vophucthinh2006/DrowsyGuard-EdgeAI-HackTheChallenge2026/specs/09-ui-dashboard-spec.md

# 09 — UI Dashboard Specification (UI-SPEC-09)

**Document:** DG-SPEC-09 · Rev 0.1 · 2026-08-11 · DRAFT
**Applies to:** DrowsyGuard Desktop Demo (UI + Bridge)

---

## 1. Purpose and scope

### 1.1 Purpose

This document specifies the requirements, architecture, data interfaces and UI behaviour for the
desktop demonstration application that implements a vehicle-style instrument cluster ("car
display") for the DrowsyGuard system. The application is intended for demo and developer use and
must be capable of running with live CAN data, replayed traces, or fully simulated inputs.

### 1.2 Scope — in

- Desktop UI application that renders speedometer, secondary gauge (RPM/HP), odometer, ambient
  temperature, and vehicle indicator icons.
- Realtime reception and rendering of CAN-derived vehicle signals.
- Hard-realtime rendering of alert events produced by the UNO Q node and visualisation of the
  corresponding hardware actions (buzzer, vibration, fan, etc.).
- Developer modes: `live`, `replay`, `simulate` with configurable mapping from the canonical
  ICD (`shared/icd/icd.yaml`).

### 1.3 Scope — out

- This tool is a demonstration/UI product only and does not implement vehicle control logic.
- It shall not be used as a safety controller; the VCS MCU remains the single-source-of-truth for
  safety-critical actuation.

---

## 2. System context

The UI sits alongside a small native bridge service which performs CAN and serial I/O. The
bridge exposes a local WebSocket API consumed by the Electron UI. The diagram below shows the
logical data flows.

```
            +--------------------------+     WebSocket (MessagePack)     +-------------+
            |   bridge (Rust binary)   | <-------------------------------- |  UI (React)  |
            |  - reads CAN adapters     |                                   |  - renders   |
            |  - reads UNO Q serial    | -----> messages: can_signal,      |    dials &   |
            |  - replay / simulate     |        uno_alert, heartbeat,     |    alerts    |
            +-----------+--------------+                                   +------+------+
                        |  CAN frames (live or replay)                            |
                        |                                                      +-v--+
                +-------v------+                                               |Dev| 
                | CAN Adapter  |                                               |Panel|
                +--------------+                                               +----+
```

Also see the sequence overview (mermaid):

```mermaid
sequenceDiagram
  participant Bridge
  participant UI
  Bridge->>UI: can_signal (MessagePack)
  Bridge->>UI: uno_alert (MessagePack)
  UI->>UI: render/update dials
  UI->>User: show alert overlay + sound
```

---

## 3. Requirements

### 3.1 Functional

- UI-FN-001 — The UI SHALL accept messages of type `can_signal` and `uno_alert` over a local
  WebSocket and update visuals accordingly.
- UI-FN-002 — The UI SHALL provide modes `live`, `replay`, and `simulate` selectable from the
  developer panel.
- UI-FN-003 — The UI SHALL display UNO Q alerts immediately on receipt and visualise `actions`.

### 3.2 Non-functional

- UI-NF-001 — UNO Q alert end-to-end render latency SHALL target ≤ 50 ms typical, worst-case ≤ 100 ms.
- UI-NF-002 — The UI SHALL render smooth dial animation at a configurable rate (default 20 Hz).
- UI-NF-003 — WebSocket binding SHALL default to `localhost` for security.

---

## 4. Message definitions

- `can_signal` — periodic message containing decoded signal values.

```json
{
  "type": "can_signal",
  "ts": 1680000000.123,
  "signals": { "vehicle.speed_kmh": 99.0, "vehicle.rpm": 2500 }
}
```

- `uno_alert` — high-priority event originating from UNO Q.

```json
{
  "type": "uno_alert",
  "ts": 1680000001.456,
  "code": "DROWSY_L2",
  "level": 2,
  "message": "Driver drowsy - high",
  "actions": ["buzzer","vibrate","fan"]
}
```

Notes: MessagePack MUST be used at runtime for compactness and low parsing overhead; the JSON
snippets above are for documentation only.

---

## 5. Signal → Widget mapping (minimum)

- `vehicle.speed_kmh` → Speedometer (left dial, numeric + arc)
- `vehicle.rpm` → RPM / secondary gauge (right dial)
- `vehicle.odo_km` → Odometer (text)
- `vehicle.temp_c` → Temperature indicator
- boolean indicators → Top icon strip (turns, lights, seatbelt)

Mapping rules SHALL be supplied in `config/signal_map.yaml` derived from `shared/icd/icd.yaml`.

---

## 6. Alert behaviour and prioritisation

- Alerts include `level` ∈ {0,1,2,3}. UI SHALL present visual & audio behaviour by level:
  - Level 1: Amber banner (soft beep)
  - Level 2: Red overlay (loud alarm + flash)
  - Level 3: Full-screen modal (repeating alarm) — requires clear from UNO Q or timeout

- If multiple alerts present, UI SHALL surface the highest level; others are retained in the
  alert log accessible from the developer panel.

---

## 7. Performance considerations

- Use a Web Worker to decode MessagePack and forward parsed objects to the UI renderer via
  `postMessage` to avoid blocking the main thread.
- UNO alert messages MUST be processed and enqueued on a high-priority path; they must not be
  dropped due to CAN frame backpressure.
- Bridge SHALL implement bounded CAN queues and drop oldest frames when saturated.

---

## 8. UI layout & visual guidance

- Provide two resolution-aware themes (`theme/light`, `theme/dark`) and scale all canvases by
  `devicePixelRatio` for crisp rendering.
- Use vector assets (SVG) for icons. Speed numeric font size target 48–72px.
- Include accessibility options: high-contrast, large-text, disable-flash.

---

## 9. Developer deliverables

- `config/signal_map.yaml` (mapping file)
- `examples/replay/sample_replay.msgpack` and `examples/alerts/sample_alerts.msgpack`
- Build and run instructions in `README.md` at the project root.

---

## 10. Traceability

This document traces to the top-level system requirements in [01](01-system-requirements.md) and
to the CAN ICD in [04](04-interface-control-document.md).

---

End of UI specification.
