vophucthinh2006/DrowsyGuard-EdgeAI-HackTheChallenge2026/Images/drowsyguard-poster.JPG

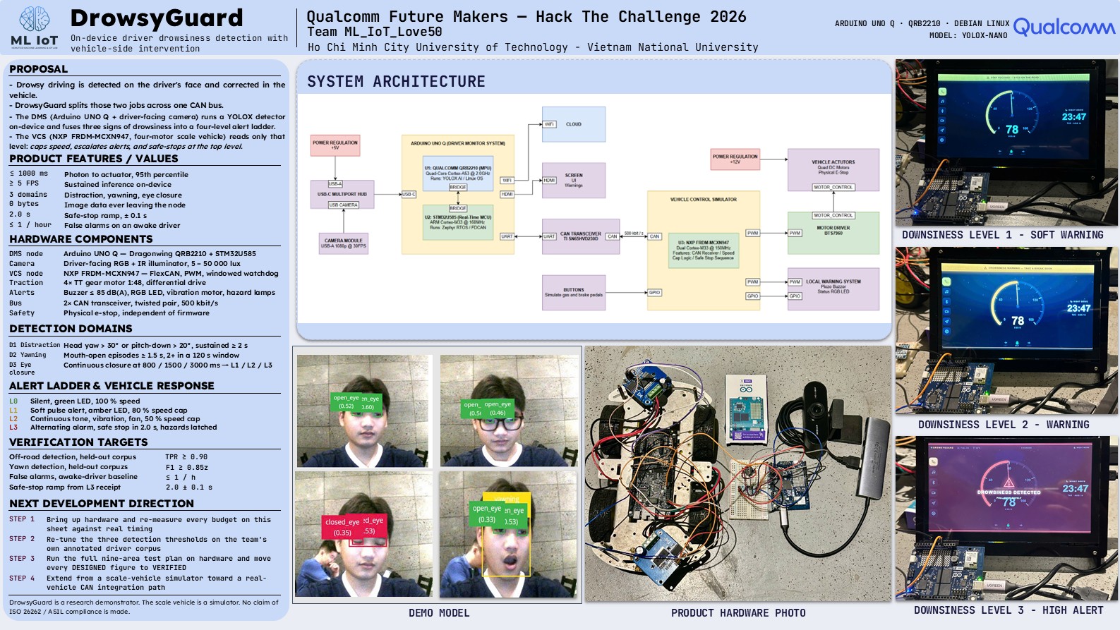
Images/drowsyguard-poster.JPG
