vophucthinh2006/DrowsyGuard-EdgeAI-HackTheChallenge2026/vcs-mcxn947/WORKLOG_2026-08-15.md

# Work log — 2026-08-15 — vcs-mcxn947 (FRDM-MCXN947 VCS node)

Session covered two phases: (1) simplifying the firmware to match the
system block diagram exactly, and (2) a full hardware bring-up debugging
session for the BTS7960 motor stage, which turned into tracking down a
silent PWM1 fault-mapping bug. Root-cause detail for phase 2's bug is in
[`PWM_FAULT_BUG_POSTMORTEM.md`](./PWM_FAULT_BUG_POSTMORTEM.md); this file is
the chronological log of everything touched.

## Phase 1 — system diagram compliance

Goal: make `vcs-mcxn947` match ONLY what's in the shared system block
diagram — no more, no less.

**Removed** (not in the diagram's "Local Warning System" / control scope):
- Vibration motor output.
- Fan relay output.
- Hazard lamps (left/right).
- ACK button input.
- REARM button input.
- Physical ESTOP_SENSE input.

**Added:**
- Gas pedal simulation via the board's own onboard **SW2** button
  (Wakeup, `P0_23`/`WAKEUP_B`) — no external wiring needed.
- Brake pedal simulation via the board's own onboard **SW3** button
  (ISP mode switch, `P0_6`/`ISPMODE_N-DEBUG`, per UM12018 Table 4 — usable
  as a general-purpose input once past boot; must not be held during
  power-on/reset since the boot ROM samples it for ISP mode selection).
- Automatic re-arm logic (`SafeConditionsSustained()` in `safety.c`,
  1000 ms of continuous safe conditions required) replacing the removed
  manual REARM button.

**Files touched:**
- `board_port/cm33_core0/app.h` — removed VIBRATION/FAN_RELAY/HAZARD_L/
  HAZARD_R/ACK_BUTTON/REARM_BUTTON/ESTOP_SENSE macros; added
  `GAS_BUTTON_GPIO`/`PIN`, `BRAKE_BUTTON_GPIO`/`PIN`.
- `board_port/cm33_core0/pin_mux.c` — matching pin init changes; removed
  now-unused `kCLOCK_Port4`/`kCLOCK_Gpio4`/`kCLOCK_Gpio2` clock enables
  (kept `kCLOCK_Port2`, still needed for PWM pin muxing).
- `src/alerts/alerts.c` / `alerts.h` — removed vibration/fan/hazard GPIO
  writes from every `Alerts_Tick()` condition branch.
- `src/safety/safety.c` / `safety.h` — `dg_safety_inputs_t` reduced to
  `throttle_nonzero`, `motor_current_ma`, `motor_rail_mv` (removed
  `operator_rearm_pressed`, `ack_pressed`, `estop_sense_asserted`).
  DISARMED→ARMED_IDLE transition is now unconditional (no calib-done gate,
  no button press needed).
- `src/main.c` — removed ACK/REARM/ESTOP_SENSE debounced-input handling;
  added `s_gasButton`/`s_brakeButton` debounced inputs with edge-detection
  logging.
- `PINOUT.md` — new file, single source of truth for the pinout (CAN, motor
  driver, buzzer+LED, gas/brake, debug console), with a "Removed
  2026-08-15" section documenting what was taken out and why.

**CAN-063 fail-safe adjustment:** "absence of a valid CAN frame is never
treated as driver-is-fine" needed refinement to distinguish two cases:
- Never had a DMS-AP peer at all (standalone bench test) → treated as safe
  (L0). Tracked via a new `haveDms` flag.
- Had a DMS-AP peer and then lost it → still treated as danger (L3), per
  the original CAN-063 intent.

`src/safety/safety.c`: `fault_can_timeout` is now
`everHadDms && (link == kDgLinkLost)` (was unconditional); alert-level
fallback is `haveDms ? kDgAlertL3Danger : kDgAlertL0Normal` when driver
state isn't known.

`src/can_link/can_link.c`: added link-state-change logging
(`LogLinkStateChange()`, `[can] link OK -> DEGRADED` etc.) and
alert-level-change logging (`[can] DMS alert_level -> L2_DROWSY`), both
gated on actual state transitions (not spammed every tick).

## Phase 2 — BTS7960 motor bring-up + PWM1 debugging

Started from: `state=RUN`, correct duty cycles computed in software, but
**zero volts** on motor M+/M- terminals and a real physical buzzer making no
sound.

### Simplified test mode added first

Per request, added a "tap SW2 = motor runs, tap SW3 = stop" latching test
mode in `main.c`'s `ControlTask` (`s_motorLatchedOn`, toggled on gas/brake
button edges) to validate the BTS7960 hardware directly, bypassing the full
vehicle-control ramp logic. (Fixed an edge-detection ordering bug introduced
while wiring this up: `prevGas`/`prevBrake` were being updated *before* the
edge check instead of after, making the latch toggle never fire — moved the
`prevGas = gas; prevBrake = brake;` assignment to run after both edge
checks.)

### 2-phase raw-GPIO-then-PWM isolation test

Added `Alerts_RunPinBringupTest()` in `alerts.c`: phase 1 reconfigures the
buzzer pin (PORT2 pin 2, J3-7) as plain GPIO and toggles it 1 Hz for 10 s
(no PWM1 involved at all); phase 2 restores the PWM1_A2 pin config and
turns the buzzer on continuously. Result: **phase 1 audible, phase 2
silent** — isolated the bug specifically to PWM1, ruling out pin/wiring/
board-level causes.

### Reference example cross-check

Built and flashed the MCUXpresso SDK's own **unmodified**
`driver_examples/pwm/pwm_3ph` example directly (bypassing this project's
codebase). Confirmed audible PWM output on the same physical buzzer —
proved hardware/board/SDK were all fine, and the bug had to be in this
project's own source.

### Root cause found and fixed

Added a live PWM1 register dump to the phase-2 test. Found
`PWM1->SM[2].DISMAP[0] == 0xFFFF` (silicon reset default — not something
this project's code had set) mapping all 4 fault inputs to disable every
PWM1 output on every submodule, combined with those fault inputs floating
high (unconnected — this design has no fault sensors) and the default
combinational fault path being live. `FCTRL`/`FSTS`/`DISMAP` are PWM1-
module-wide, explaining why buzzer *and* all motor channels were silent at
once. Full analysis in
[`PWM_FAULT_BUG_POSTMORTEM.md`](./PWM_FAULT_BUG_POSTMORTEM.md).

**Fix:** `board_port/cm33_core0/hardware_init.c` now explicitly clears
`PWM1->SM[0..3].DISMAP[0] = 0U` right after the PWM1 sub-clock enables.

**Verification so far:** rebuilt (`-Werror`, 0 warnings), reflashed,
captured two independent serial register dumps confirming `OUTEN`/`MCTRL`/
duty registers (`VAL3 = 25000`, 50% of a 50000-tick period) and `DISMAP`'s
functional bits all read back correct. **Audible confirmation on real
hardware is still pending** as of this writeup.

### Other real (if minor) bugs found and fixed along the way

- `SYSCON->PWM1SUBCTL` was only enabling sub-clocks for 3 submodules
  (`CLK0_EN|CLK1_EN|CLK2_EN`) while this project actually uses 4
  (SM0/1/2/3 — SM3 borrowed for the right motor's LPWM since SM1's own B
  channel isn't header-accessible). Added `CLK3_EN`. Real bug, but
  insufficient alone to explain full silence — see postmortem.
- Missing WWDT0 functional clock, found earlier by flashing to hardware:
  without it, `WWDT_Init()`'s internal wait-for-clock spin hung boot
  silently. Fixed with `CLOCK_SetClkDiv(kCLOCK_DivWdt0Clk, 1U)` +
  `SYSCON_CLOCK_CTRL_FRO1MHZ_CLK_ENA_MASK` in `hardware_init.c`.

## Files with uncommitted changes as of this writeup

```
 M board_port/cm33_core0/hardware_init.c
 M src/alerts/alerts.c
 M src/alerts/alerts.h
 M src/can_link/can_link.c
 M src/main.c
 M src/motion/motion.c
 M src/safety/safety.c
```

## Pending / next steps

1. **Get audible confirmation from the user** that the buzzer (and then the
   motors) actually work now that `DISMAP` is cleared.
2. Once confirmed, clean up all temporary bring-up/debug code (full list in
   `PWM_FAULT_BUG_POSTMORTEM.md`'s "Cleanup still pending" section):
   - Remove `Alerts_RunPinBringupTest()` and its call site.
   - Remove the bisection `PRINTF`s and register dump added to `alerts.c`.
   - Restore `AlertTask`'s normal `Alerts_Tick()` loop in `main.c` (currently
     replaced with a halt-loop; the original logic is preserved as a
     comment block).
   - Remove `Alerts_ForceBuzzerOnForTest()` (unused).
   - Restore the ramped `GAS_RAMP_PCT_PER_S`/`BRAKE_RAMP_PCT_PER_S`
     hold-to-drive throttle behavior in `ControlTask` (currently
     instant-latching for the hardware bring-up test).
3. Re-test the full vehicle safe-stop sequence end-to-end with working
   motors (RUN → LIMITED → DECEL → STOPPED, fault/estop paths) now that the
   actuation layer is confirmed real.
